SanTiwari07/PotHoleDetection/demo/examples/road_1.jpg

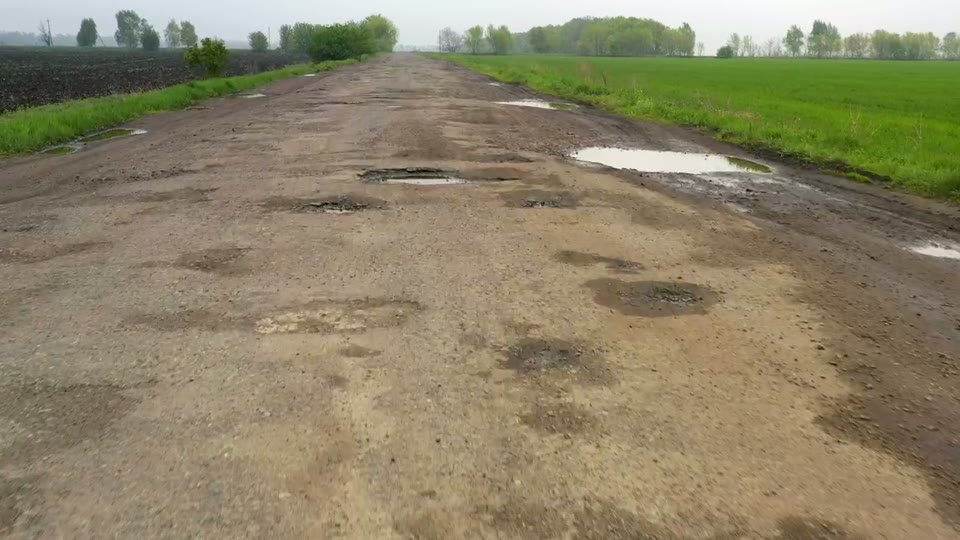
demo/examples/road_1.jpg
