SanTiwari07/PotHoleDetection/demo/examples/road_2.jpg

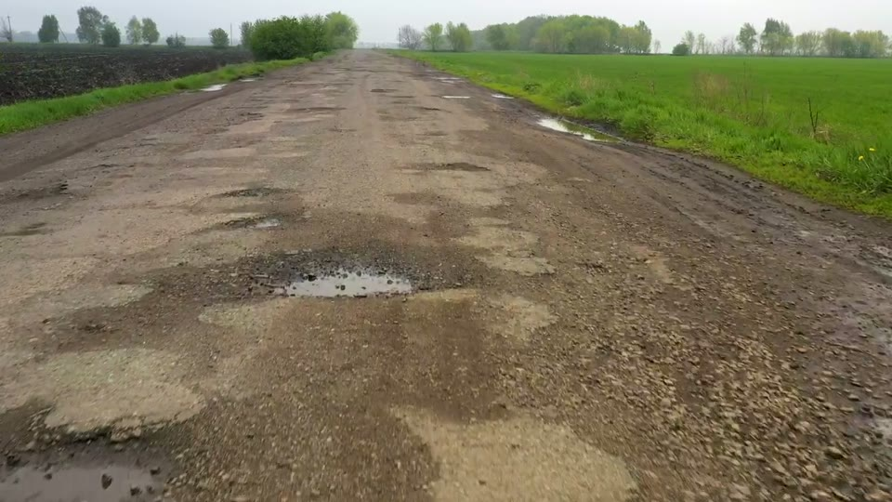
demo/examples/road_2.jpg
