SanTiwari07/PotHoleDetection/KiCad/IPDS_SensorNode/IPDS_SensorNode.kicad_pcb

## KiCad design KiCad/IPDS_SensorNode/IPDS_SensorNode.kicad_pcb (2026-10-08)

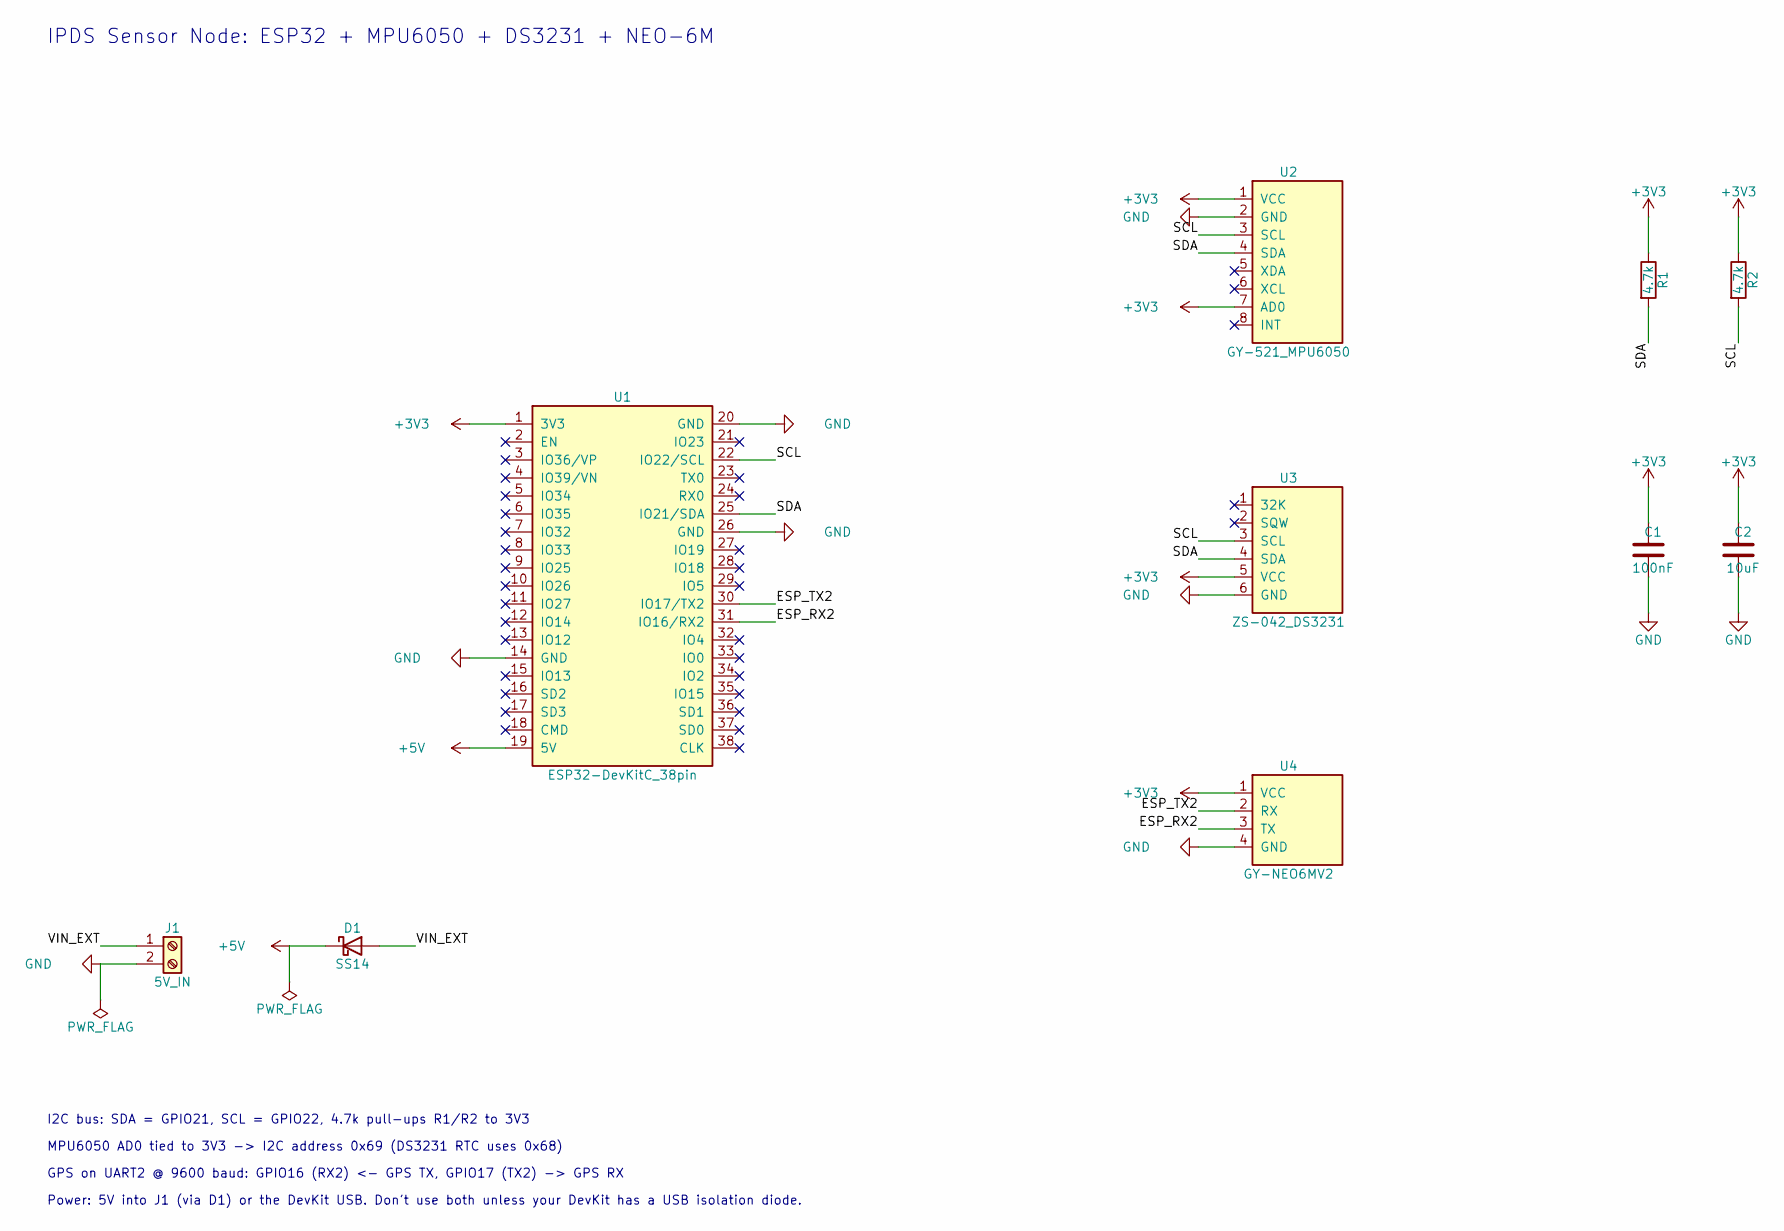
[picture p10: schematic IPDS_SensorNode.kicad_sch, IPDS Sensor Node]

Parts:
C1: 100nF; C_0805_2012Metric
C2: 10uF; C_0805_2012Metric
D1: SS14; D_SMA
J1: 5V_IN; TerminalBlock_Phoenix_MKDS-1,5-2-5.08_1x02_P5.08mm_Horizont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
R1, R2: 4.7k; R_0805_2012Metric
U1: ESP32-DevKitC_38pin; ESP32_DevKitC_38_Socket
U2: GY-521_MPU6050; PinSocket_1x08_P2.54mm_Vertical
U3: ZS-042_DS3231; PinSocket_1x06_P2.54mm_Vertical
U4: GY-NEO6MV2; PinSocket_1x04_P2.54mm_Vertical

Connections:
+3V3: C1.1, C2.1, R1.1, R2.1, U1.1 (3V3), U2.1 (VCC), U2.7 (AD0), U3.5 (VCC), U4.1 (VCC)
+5V: D1.1 (K), U1.19 (5V)
/ESP_RX2: U1.31 (IO16/RX2), U4.3 (TX)
/ESP_TX2: U1.30 (IO17/TX2), U4.2 (RX)
/SCL: R2.2, U1.22 (IO22/SCL), U2.3 (SCL), U3.3 (SCL)
/SDA: R1.2, U1.25 (IO21/SDA), U2.4 (SDA), U3.4 (SDA)
/VIN_EXT: D1.2 (A), J1.1
GND: C1.2, C2.2, J1.2, U1.14 (GND), U1.20 (GND), U1.26 (GND), U2.2 (GND), U3.6 (GND), U4.4 (GND)

Notes on the sheet:
IPDS Sensor Node: ESP32 + MPU6050 + DS3231 + NEO-6M
I2C bus: SDA = GPIO21, SCL = GPIO22, 4.7k pull-ups R1/R2 to 3V3
MPU6050 AD0 tied to 3V3 -> I2C address 0x69 (DS3231 RTC uses 0x68)
GPS on UART2 @ 9600 baud: GPIO16 (RX2) <- GPS TX, GPIO17 (TX2) -> GPS RX
Power: 5V into J1 (via D1) or the DevKit USB. Don't use both unless your DevKit has a USB isolation diode.

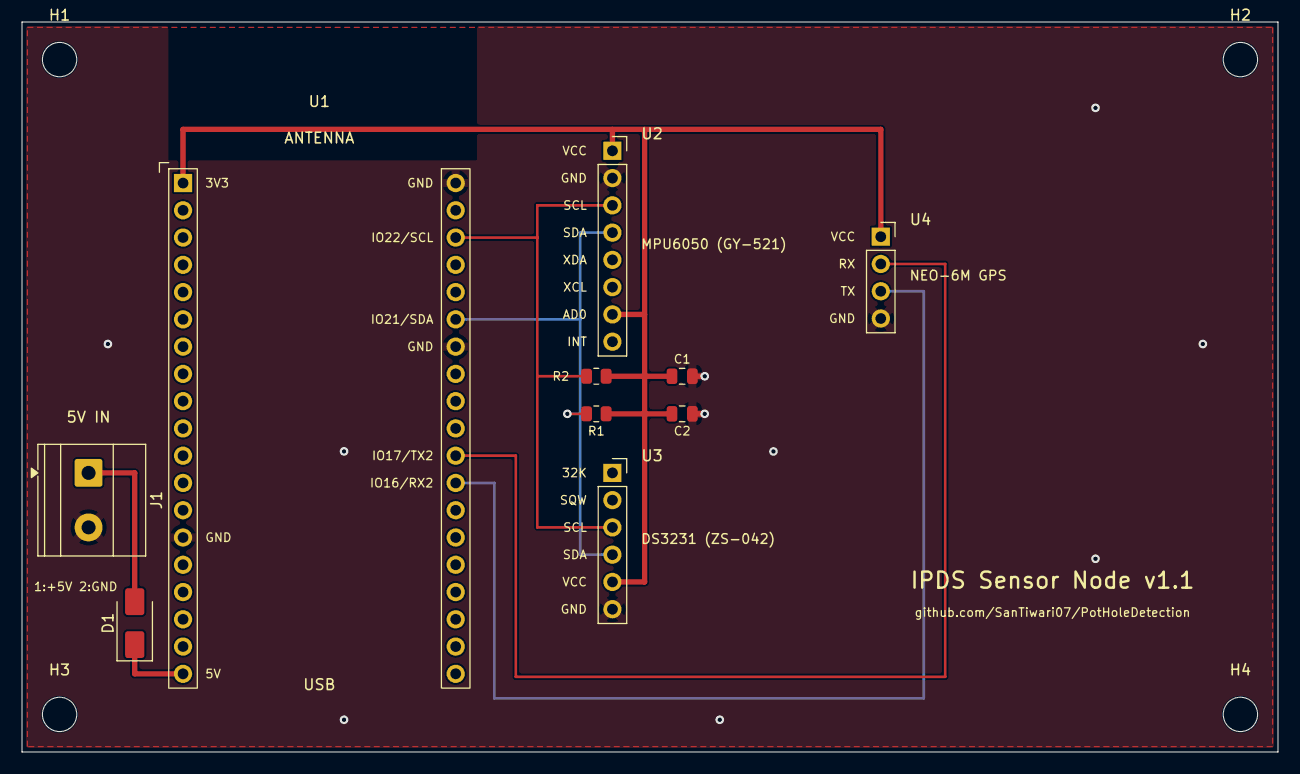
[picture p11: board IPDS_SensorNode.kicad_pcb from above]

Board: 2 copper layers, 117.0 x 68.0 mm, 14 parts (0 on the bottom side), 8 nets.

Other parts of the board:
H1, H2, H3, H4: M3; MountingHole_3.2mm_M3
