SanTiwari07/PotHoleDetection/ESP_32_Code/esp_32_final/credentials.example.h

// Template for credentials.h (which is git-ignored).
// Recommended: fill in .env in the repo root and run `python update_wifi.py`,
// which generates credentials.h for both sketches automatically.
// Manual alternative: copy this file to credentials.h and edit the values below.

const char* ssid = "YourNetworkName";
const char* password = "YourPassword";
