SanTiwari07/PotHoleDetection/(commit log)

2026-06-18 Update output.csv and fix gitignore
    [output.csv]
2026-06-18 chore: publication-ready repository restructure
    - Add comprehensive README.md (17 sections, full academic documentation)
    - Add MIT LICENSE for all 4 authors
    - Add CITATION.cff (CFF 1.2.0, all 4 authors, PICT affiliation)
    - Update .gitignore (exclude .env, __pycache__, *.pyc, .vscode/, .idea/)
    - Add outputs/sample_logs/output.csv (curated 50-detection field-test log)
    - Untrack .env and __pycache__ from version history
    [output.csv]
2026-10-08 Update KiCad sensor node PCB layout, symbol libraries, and fabrication outputs
    [IPDS_SensorNode.kicad_pcb, IPDS_SensorNode.kicad_sch, IPDS_SensorNode_BOM.csv]
2026-10-08 Refactor ESP32 firmware and replace hardcoded credentials with example headers
    [credentials.example.h, esp_32_final.ino]
2026-10-08 Clean up Python processing pipeline, add sensor fusion module, and introduce automated tests
    [output.csv]
2026-10-08 Add Streamlit web demo application with sample road imagery and animated demonstration
2026-10-08 Enhance ESP32 firmware with watchdog timers, hardware boot self-test, and MPU6050 calibration tool
2026-10-08 Add geometric false-positive filters and implement sensor fusion confirmation gate
2026-10-08 Expand automated test suite with geometric filter and impact gate test cases
2026-10-08 Update documentation with MPU6050 calibration instructions, boot diagnostics, and fusion formulas
2026-10-08 Center and constrain SVG in schematic viewer
2026-10-08 Clean up ESP32 firmware thresholding, escape WiFi credentials, and refine docs
2026-10-08 Add hardware prototype photographs to website and README
2026-10-08 Remove obsolete supplementary files and local KiCad settings, update repo structure in README
2026-10-10 Add GeoJSON export for pothole logs (#17)
    Adds python/export_geojson.py and pothole_detection/geojson_export.py to
    convert a pothole log CSV into a GeoJSON FeatureCollection for QGIS,
    geojson.io, uMap and Google My Maps. Rows with no usable GPS position
    (offline runs, 0,0 no-fix, out of range) are skipped and counted. Handles
    both the numeric severity written by main.py and the Low/Medium/High text
    bands in the sample log.
    Also documents the exporter in the README, ticks it off the roadmap, and
    adds a 'show your build' call to action.
